transmogrifox/Teensy_Smoker_Controller/photos/DSC02679.JPG

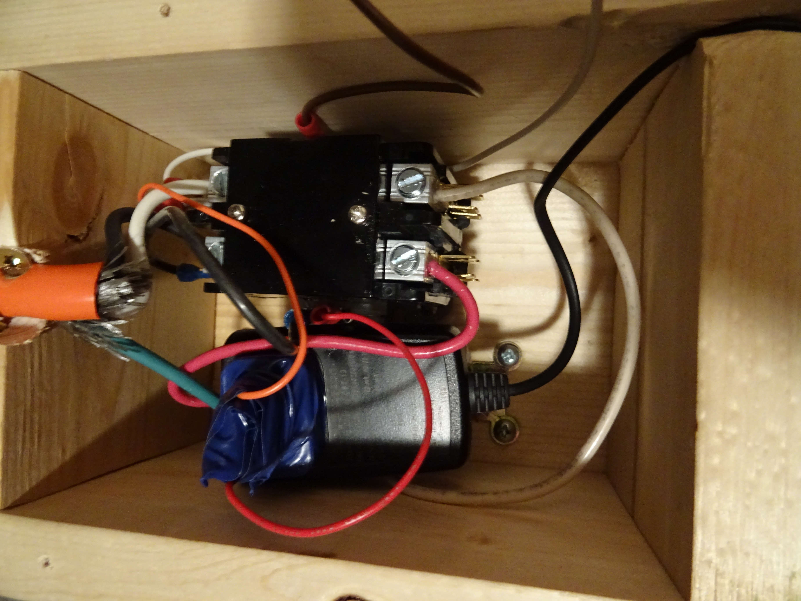
photos/DSC02679.JPG
