transmogrifox/Teensy_Smoker_Controller/photos/DSC02680.JPG

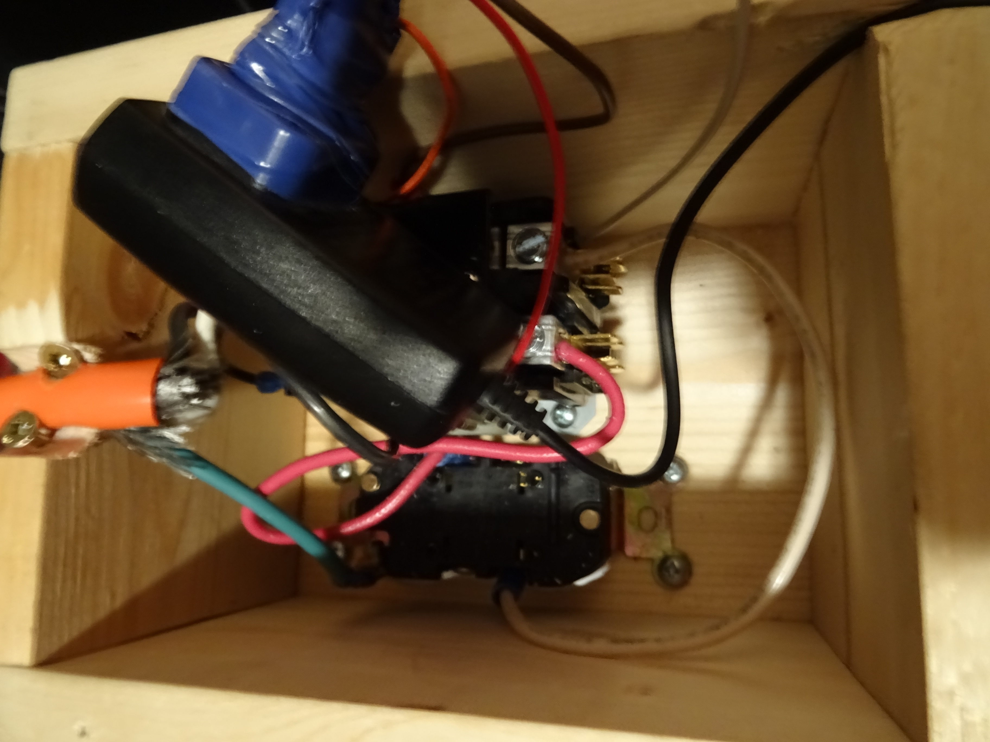
photos/DSC02680.JPG
