transmogrifox/Teensy_Smoker_Controller/Teensy_Temp_Controller_Schematic--crude_hand-drawn.pdf

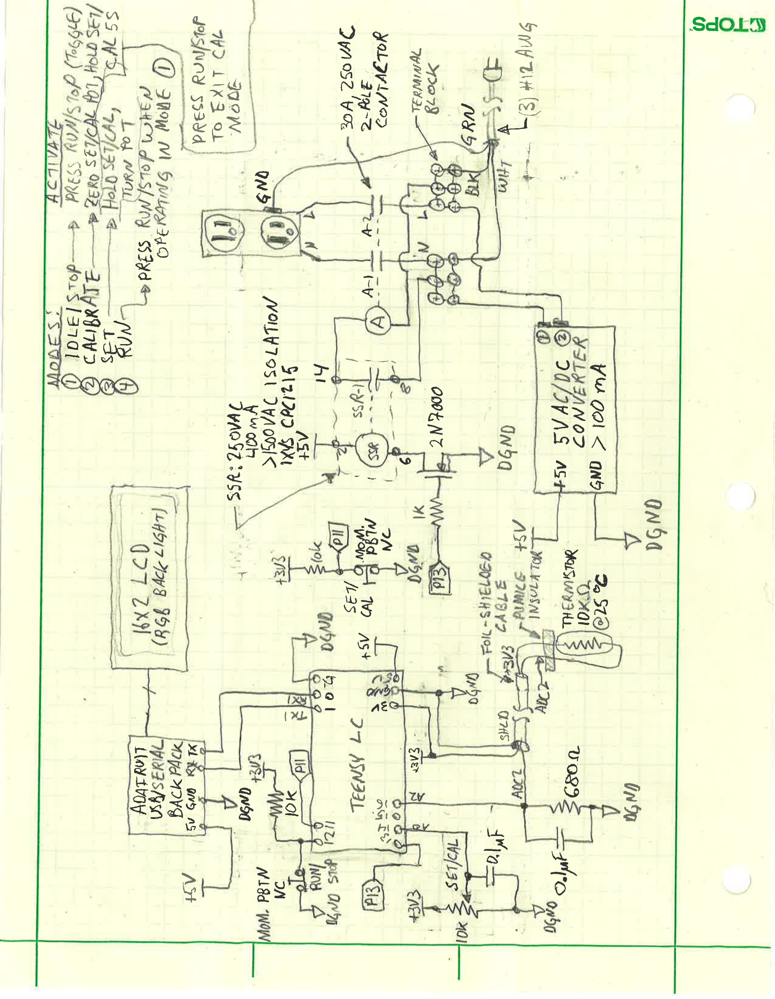
[picture p3: page 1]
