transmogrifox/Teensy_Smoker_Controller/Thermistor_Beta_Equations.pdf

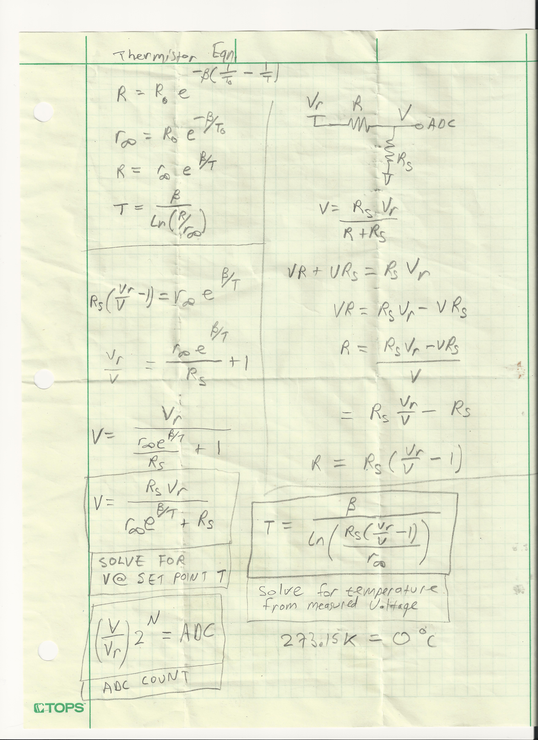
[picture p4: page 1]
