transmogrifox/Teensy_Smoker_Controller/photos/DSC02678.JPG

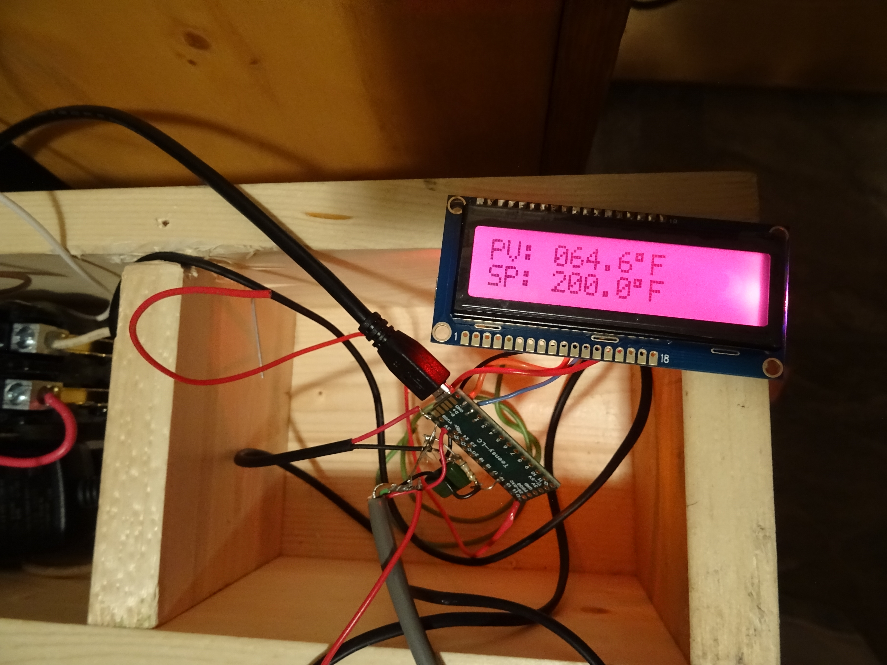
photos/DSC02678.JPG
