transmogrifox/Teensy_Smoker_Controller/photos/DSC02681.JPG

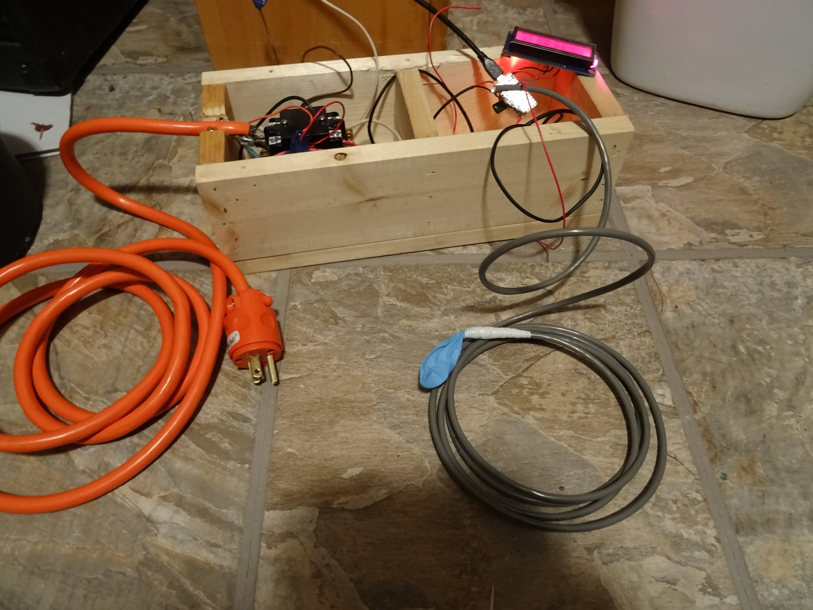
photos/DSC02681.JPG
