transmogrifox/Teensy_Smoker_Controller/photos/DSC02682.JPG

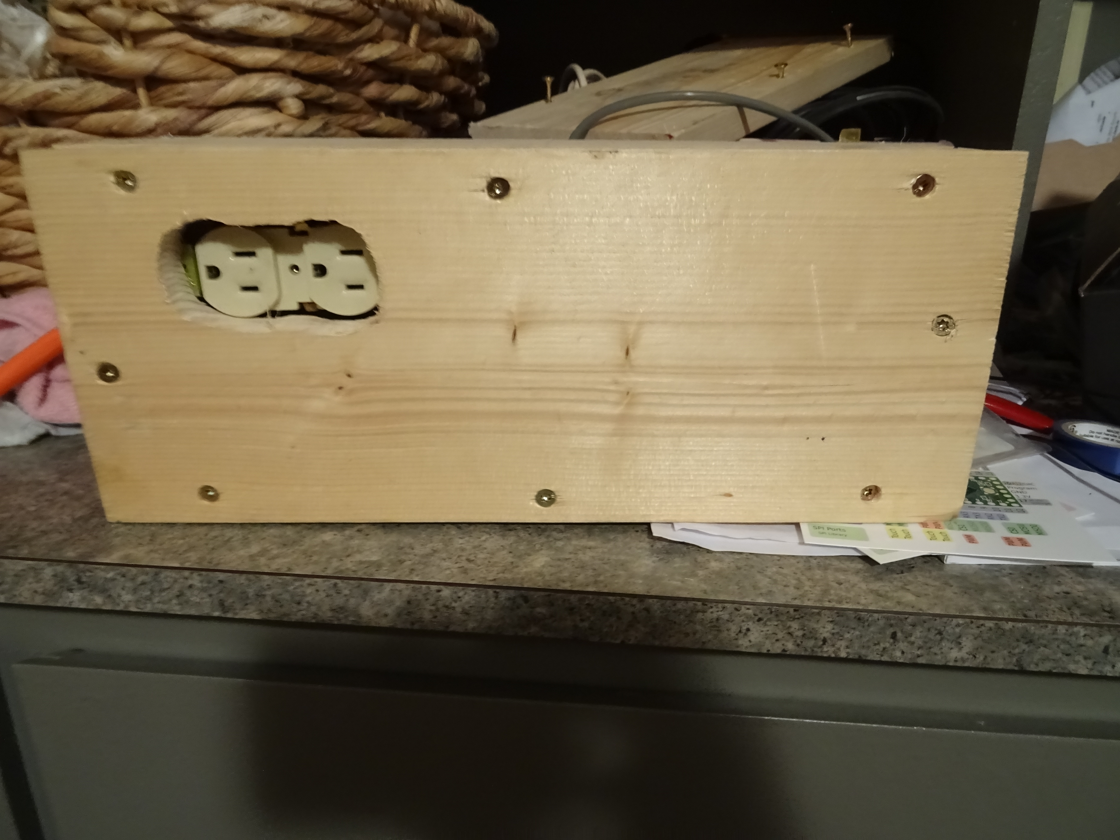
photos/DSC02682.JPG
