transmogrifox/Teensy_Smoker_Controller/(commit log)

2017-09-29 Simulation program source and spreadsheet.
    [Thermistor_Equations.xlsx]
2017-09-29 Improve sample rate adjustment #defines
2017-10-01 Add Teensy Code
2017-10-03 Add hand-drawn schematic
2017-10-08 Add ability to dial in temperature control set point with pot
2017-11-04 add timer and min max temp menus
2019-01-23 Update some things
    [Thermistor_Equations.xlsx]
2019-02-03 Update and reorganize code for PID controller new file: src/PID_version/calc/typeIII.m new file: src/PID_version/calc/typeIII_BLT.m new file: src/PID_version/lib/iir_compensator.cpp new file: src/PID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
    [Compensator_IIR.ods]
2019-02-09 Add LCD output and pots
    [Thermistor_Equations.xlsx]
2019-02-11 Bug fixes and add external smoke generator control.
    [teensy_smoker_pid_ino.ino]
